onissan/digital_power/requirement.PNG

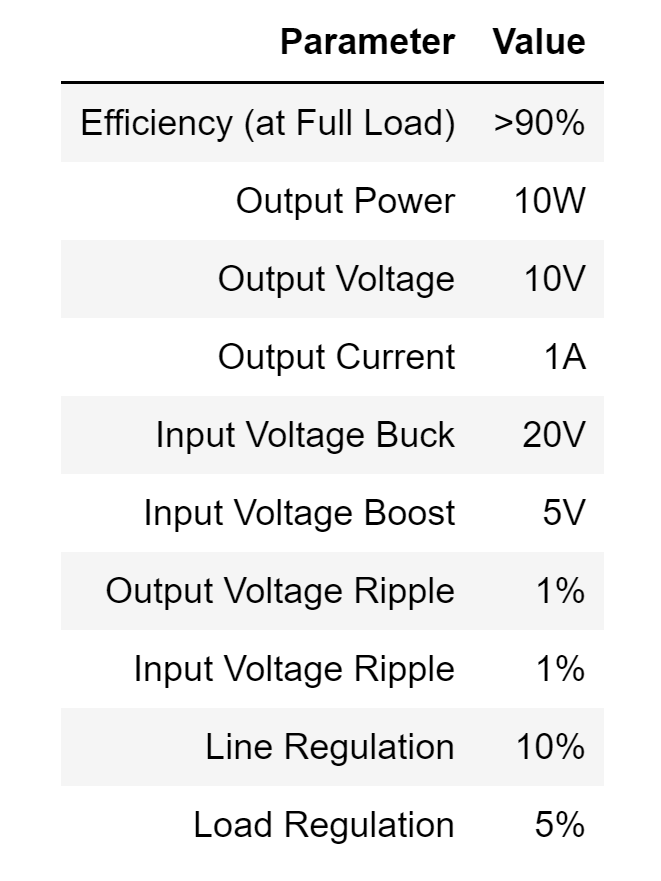
requirement.PNG
