onissan/digital_power/digital_power.pdf

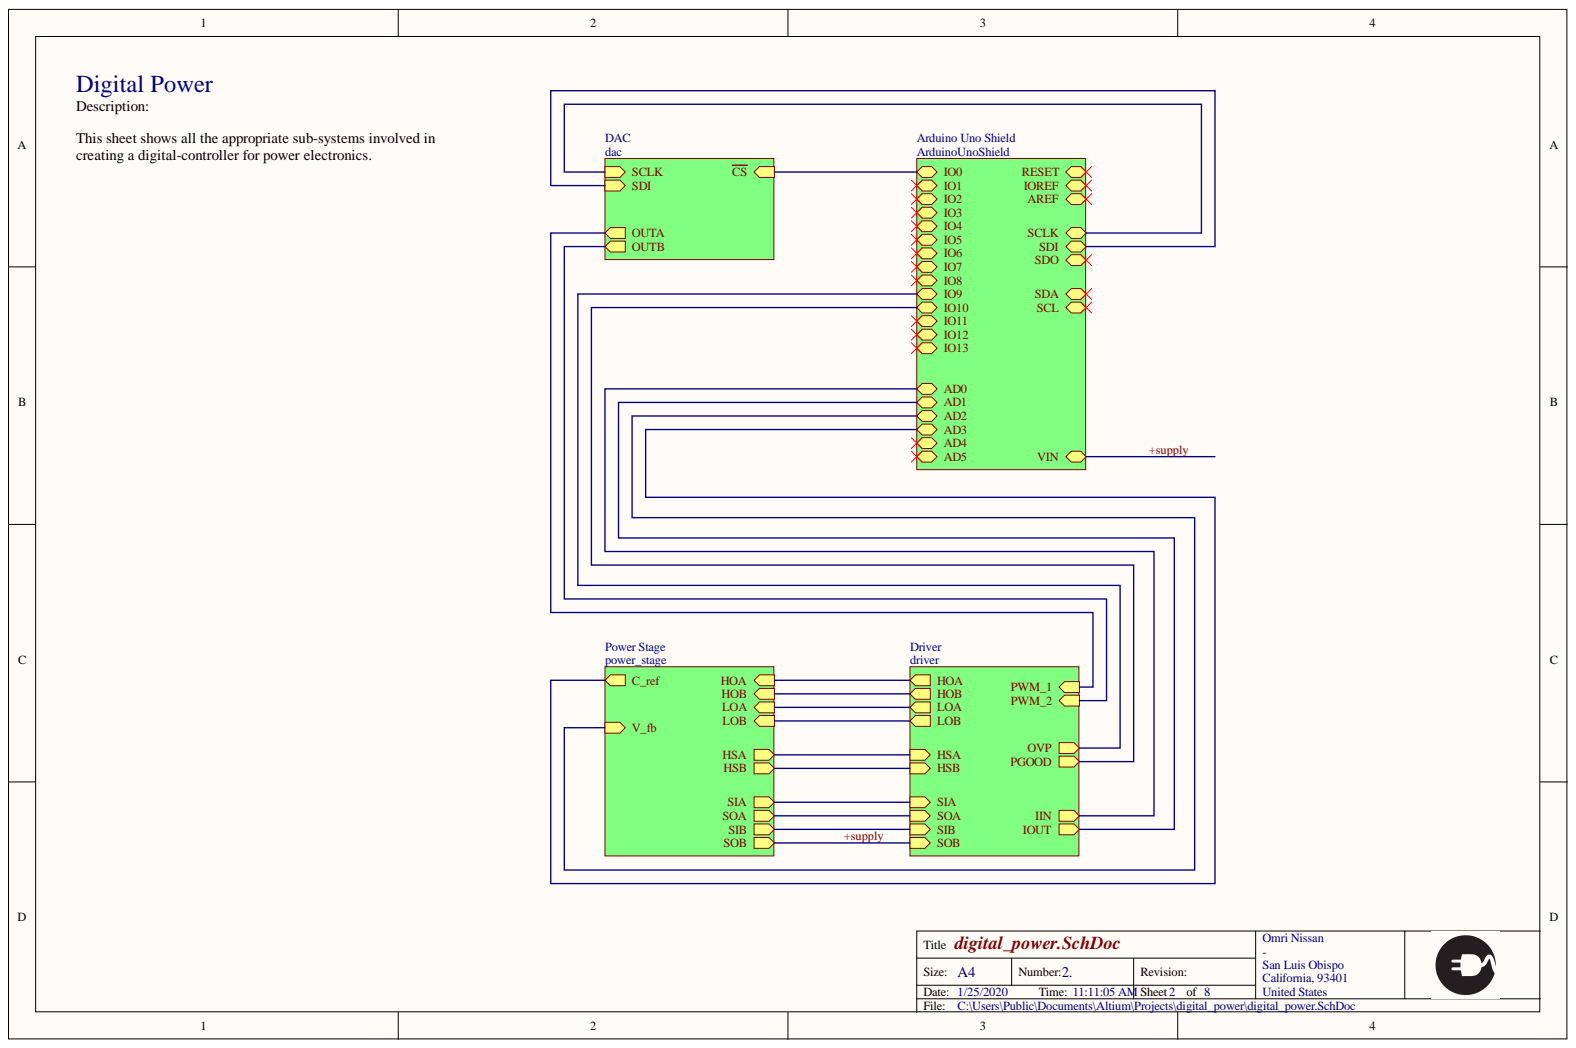
[picture p2: page 1]

This sheet shows all the appropriate sub-systems involved in
creating a digital-controller for power electronics.

Title digital_power.SchDoc | Omri Nissan -San Luis Obispo California, 93401 United States

Size: A4 | Number: 2. | Revision:

Date: 1/25/2020 Time: 11:11:05 AM | | Sheet 2 of 8
File: C:\Users\Public\Documents\Altium\Projects\digital_power\digital_power.SchDoc

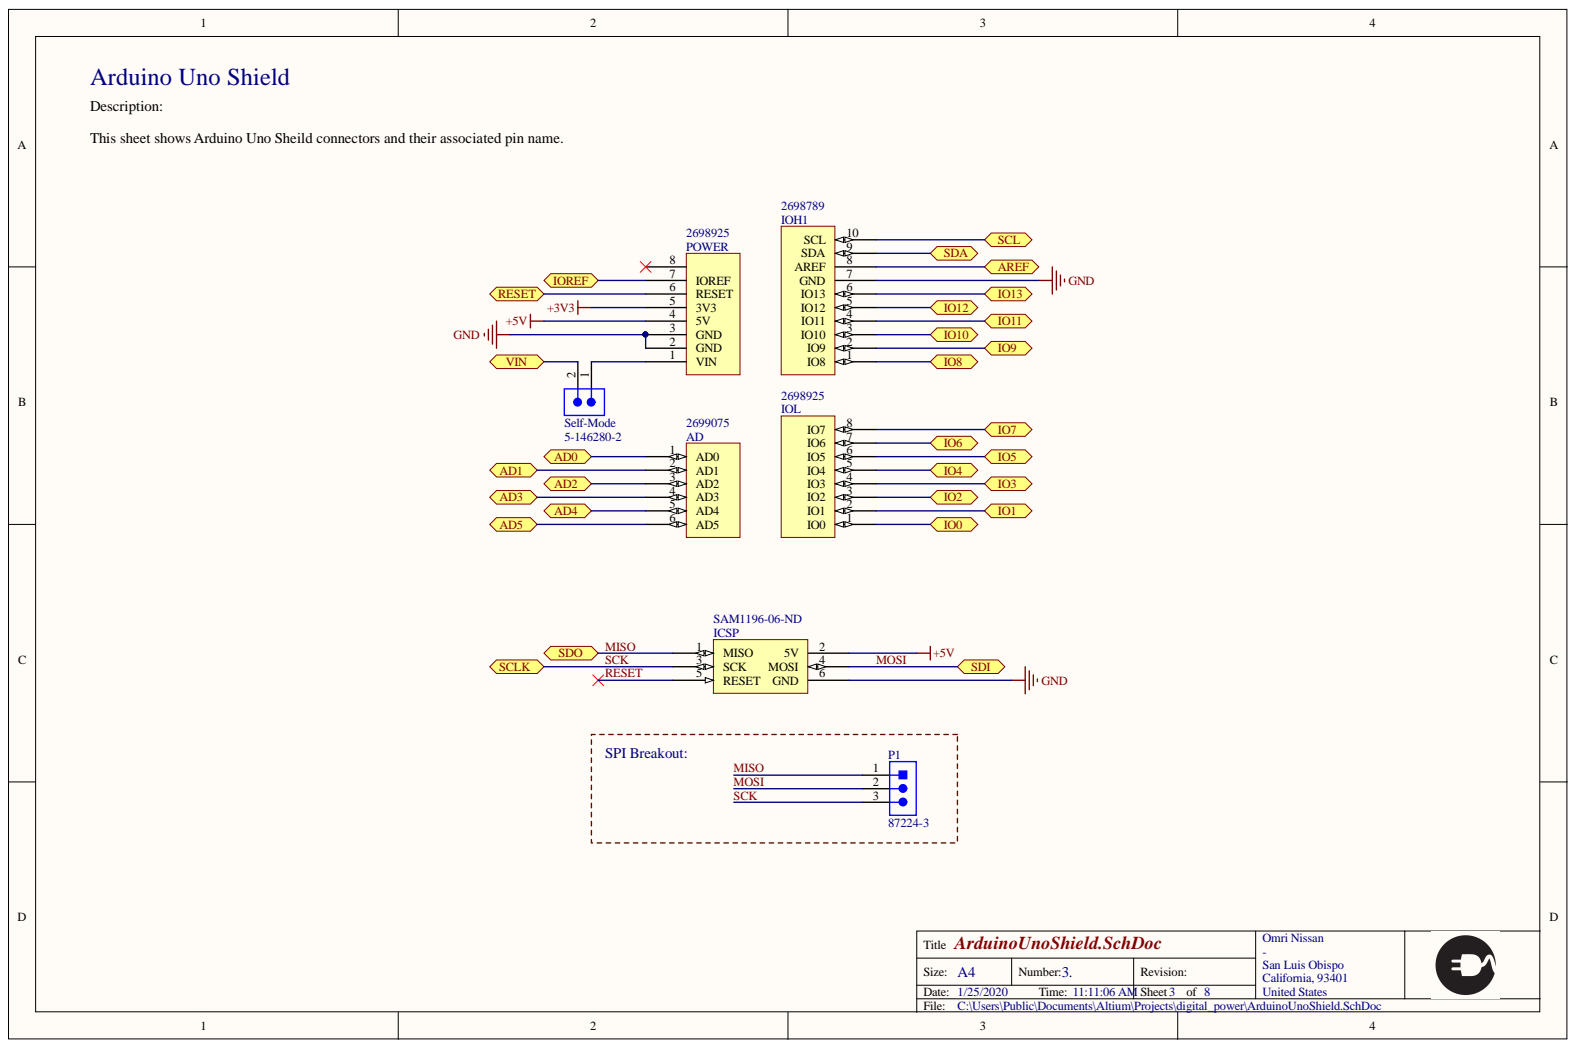
[picture p3: page 2]

This sheet shows Arduino Uno Sheild connectors and their associated pin name.

Title ArduinoUnoShield.SchDoc | Omri Nissan -San Luis Obispo California, 93401 United States

Size: A4 | Number: 3. | Revision:

Date: 1/25/2020 Time: 11:11:06 AM | | Sheet 3 of 8
File: C:\Users\Public\Documents\Altium\Projects\digital_power\ArduinoUnoShield.SchDoc

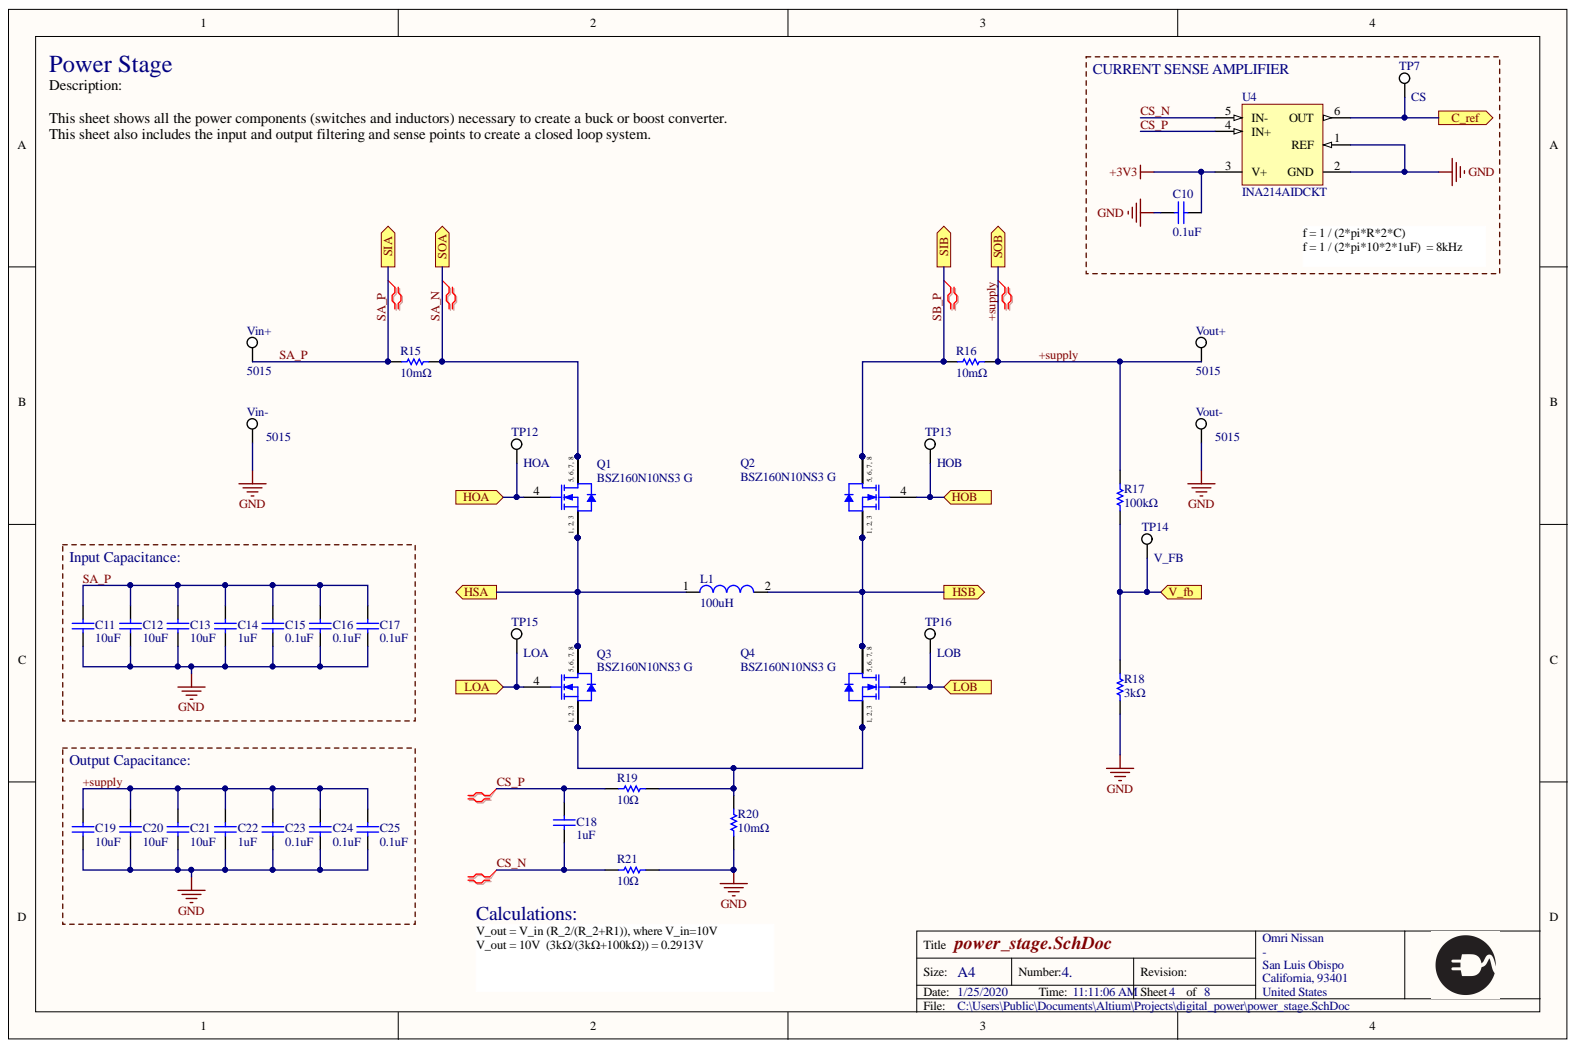
[picture p4: page 3]

This sheet shows all the power components (switches and inductors) necessary to create a buck or boost converter.
This sheet also includes the input and output filtering and sense points to create a closed loop system.

Title power_stage.SchDoc | Omri Nissan -San Luis Obispo California, 93401 United States

Size: A4 | Number: 4. | Revision:

Date: 1/25/2020 Time: 11:11:06 AM | | Sheet 4 of 8
File: C:\Users\Public\Documents\Altium\Projects\digital_power\power_stage.SchDoc

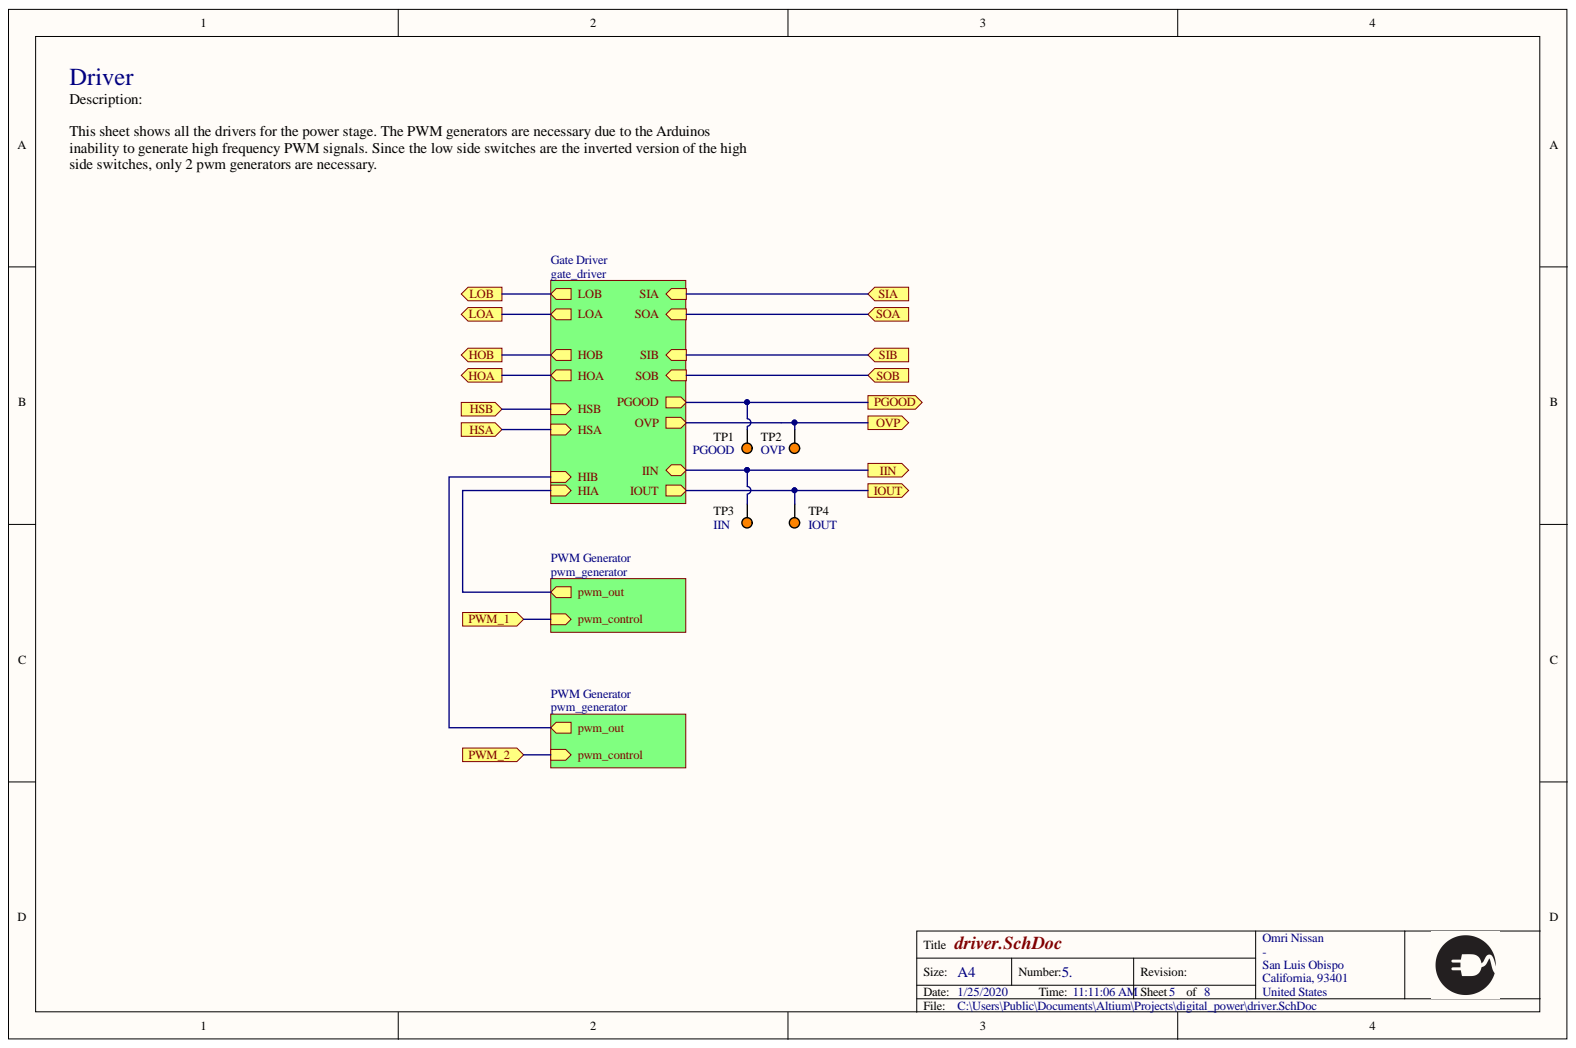
[picture p5: page 4]

This sheet shows all the drivers for the power stage. The PWM generators are necessary due to the Arduinos
inability to generate high frequency PWM signals. Since the low side switches are the inverted version of the high
side switches, only 2 pwm generators are necessary.

Title driver.SchDoc | Omri Nissan -San Luis Obispo California, 93401 United States

Size: A4 | Number: 5. | Revision:

Date: 1/25/2020 Time: 11:11:06 AM | | Sheet 5 of 8
File: C:\Users\Public\Documents\Altium\Projects\digital_power\driver.SchDoc

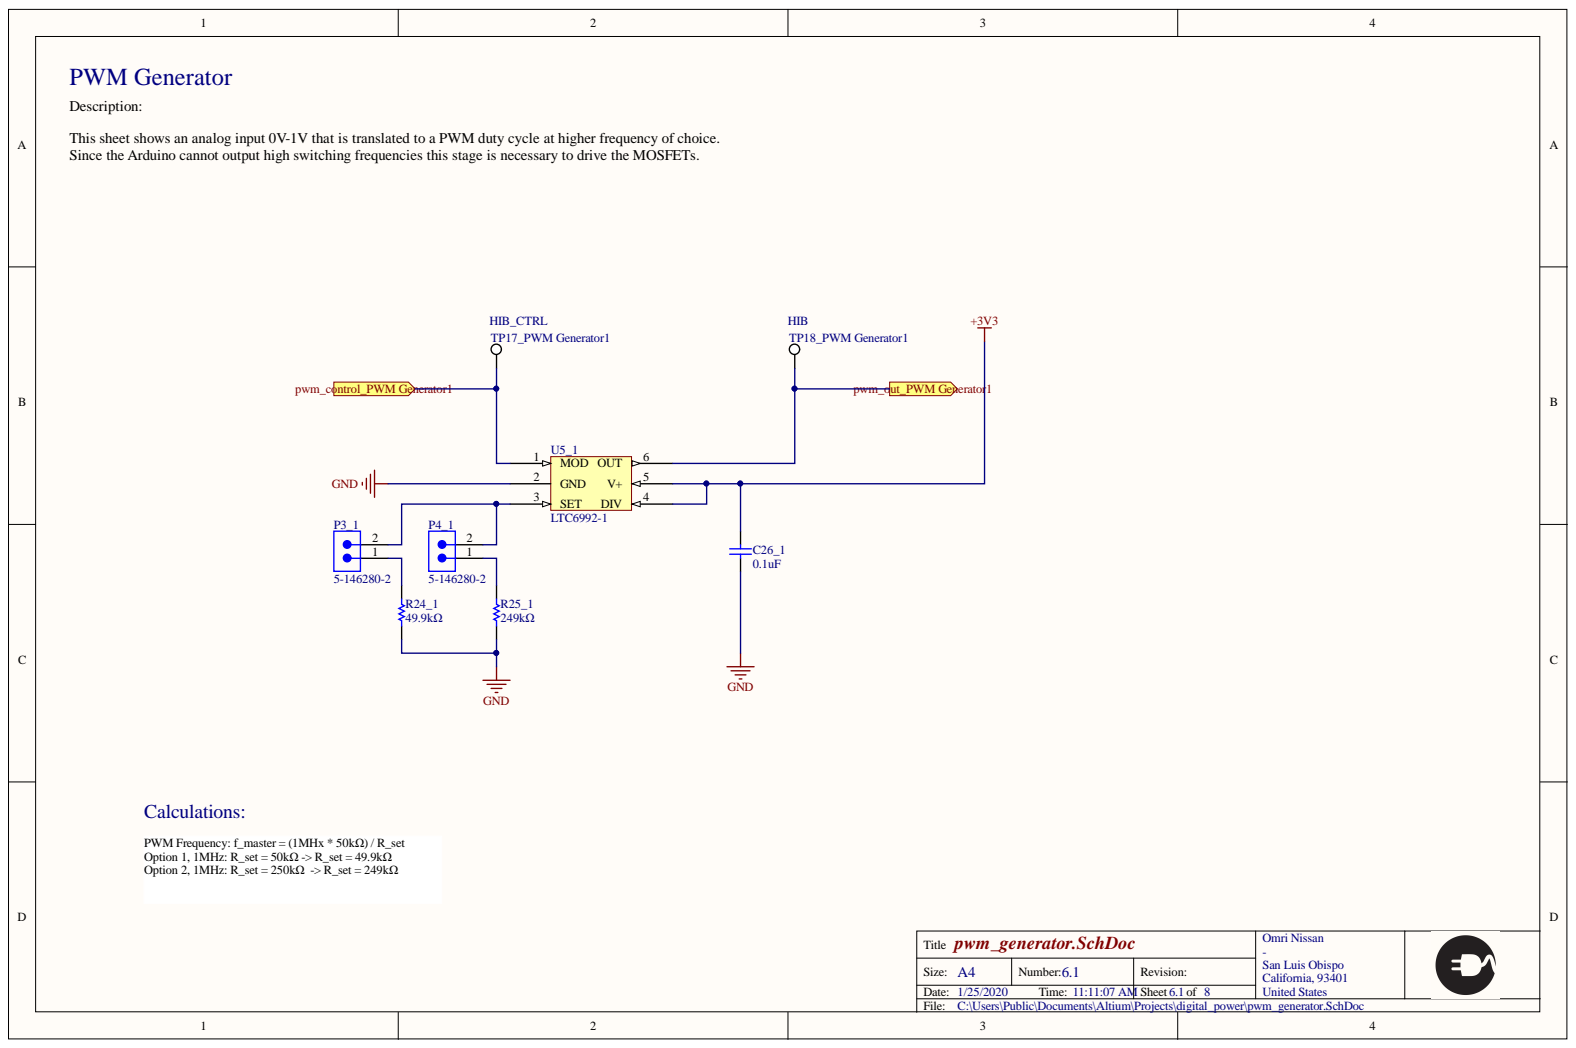
[picture p6: page 5]

This sheet shows an analog input 0V-1V that is translated to a PWM duty cycle at higher frequency of choice.
Since the Arduino cannot output high switching frequencies this stage is necessary to drive the MOSFETs.

Title pwm_generator.SchDoc | Omri Nissan -San Luis Obispo California, 93401 United States

Size: A4 | Number: 6.1 | Revision:

Date: 1/25/2020 Time: 11:11:07 AM | | Sheet 6.1 of 8
File: C:\Users\Public\Documents\Altium\Projects\digital_power\pwm_generator.SchDoc

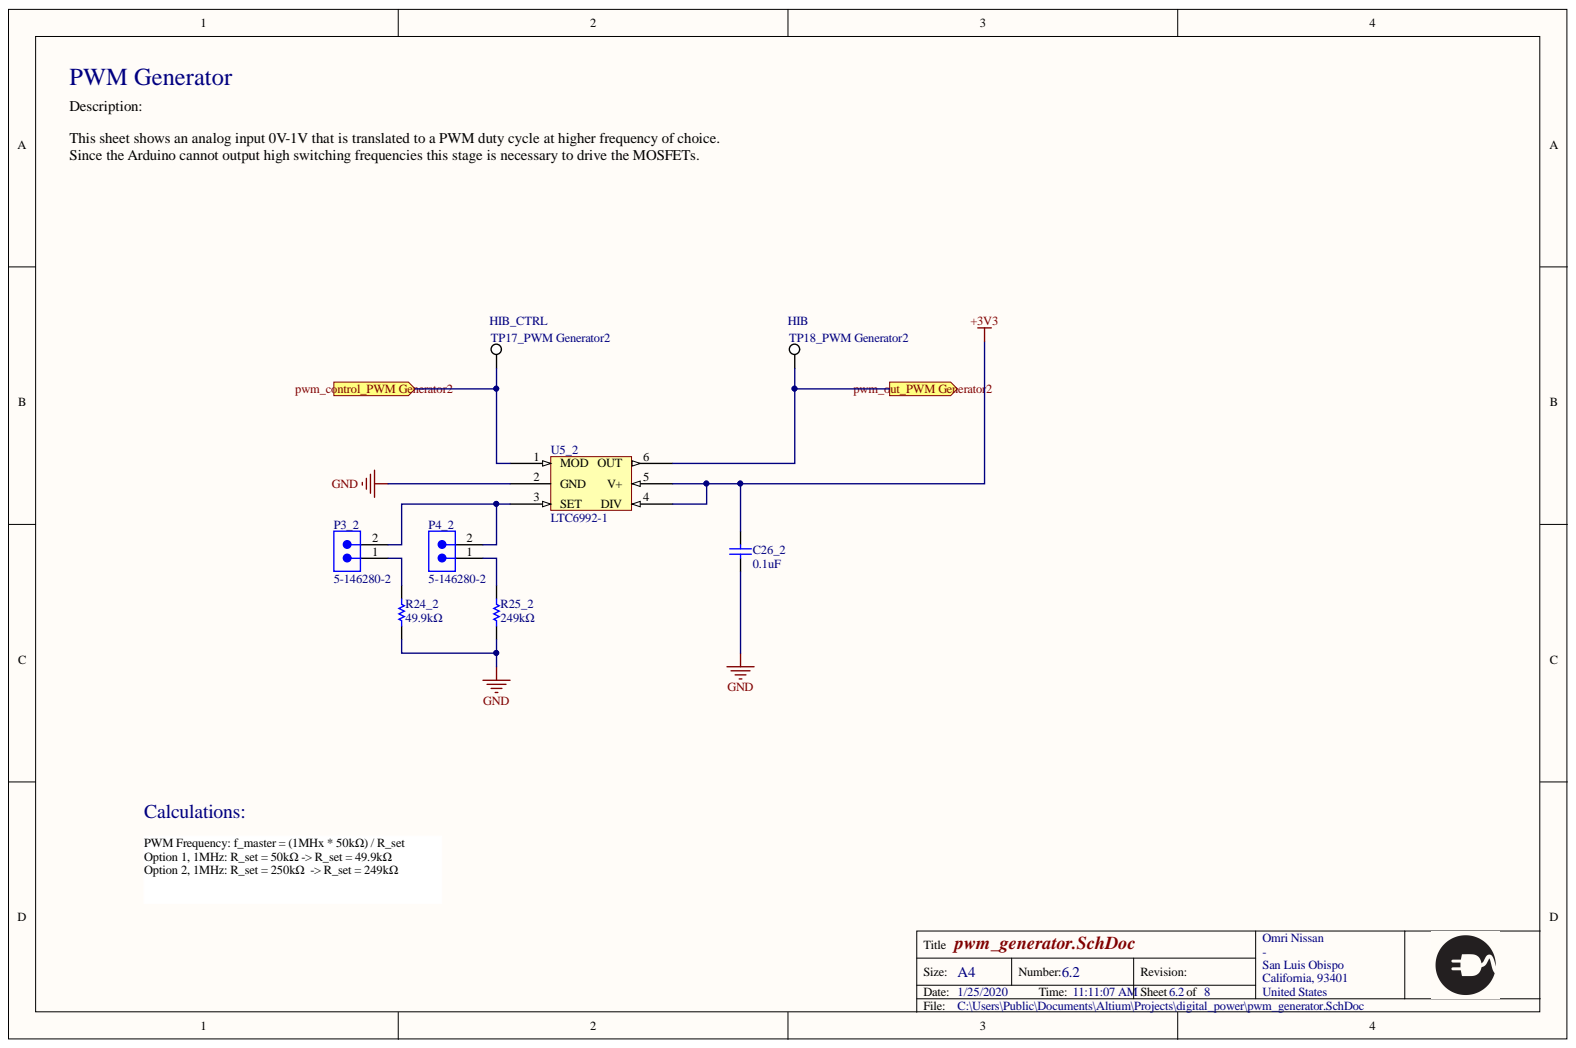
[picture p7: page 6]
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

Title pwm_generator.SchDoc | Omri Nissan -San Luis Obispo California, 93401 United States

Size: A4 | Number: 6.2 | Revision:

Date: 1/25/2020 Time: 11:11:07 AM | | Sheet 6.2 of 8
File: C:\Users\Public\Documents\Altium\Projects\digital_power\pwm_generator.SchDoc

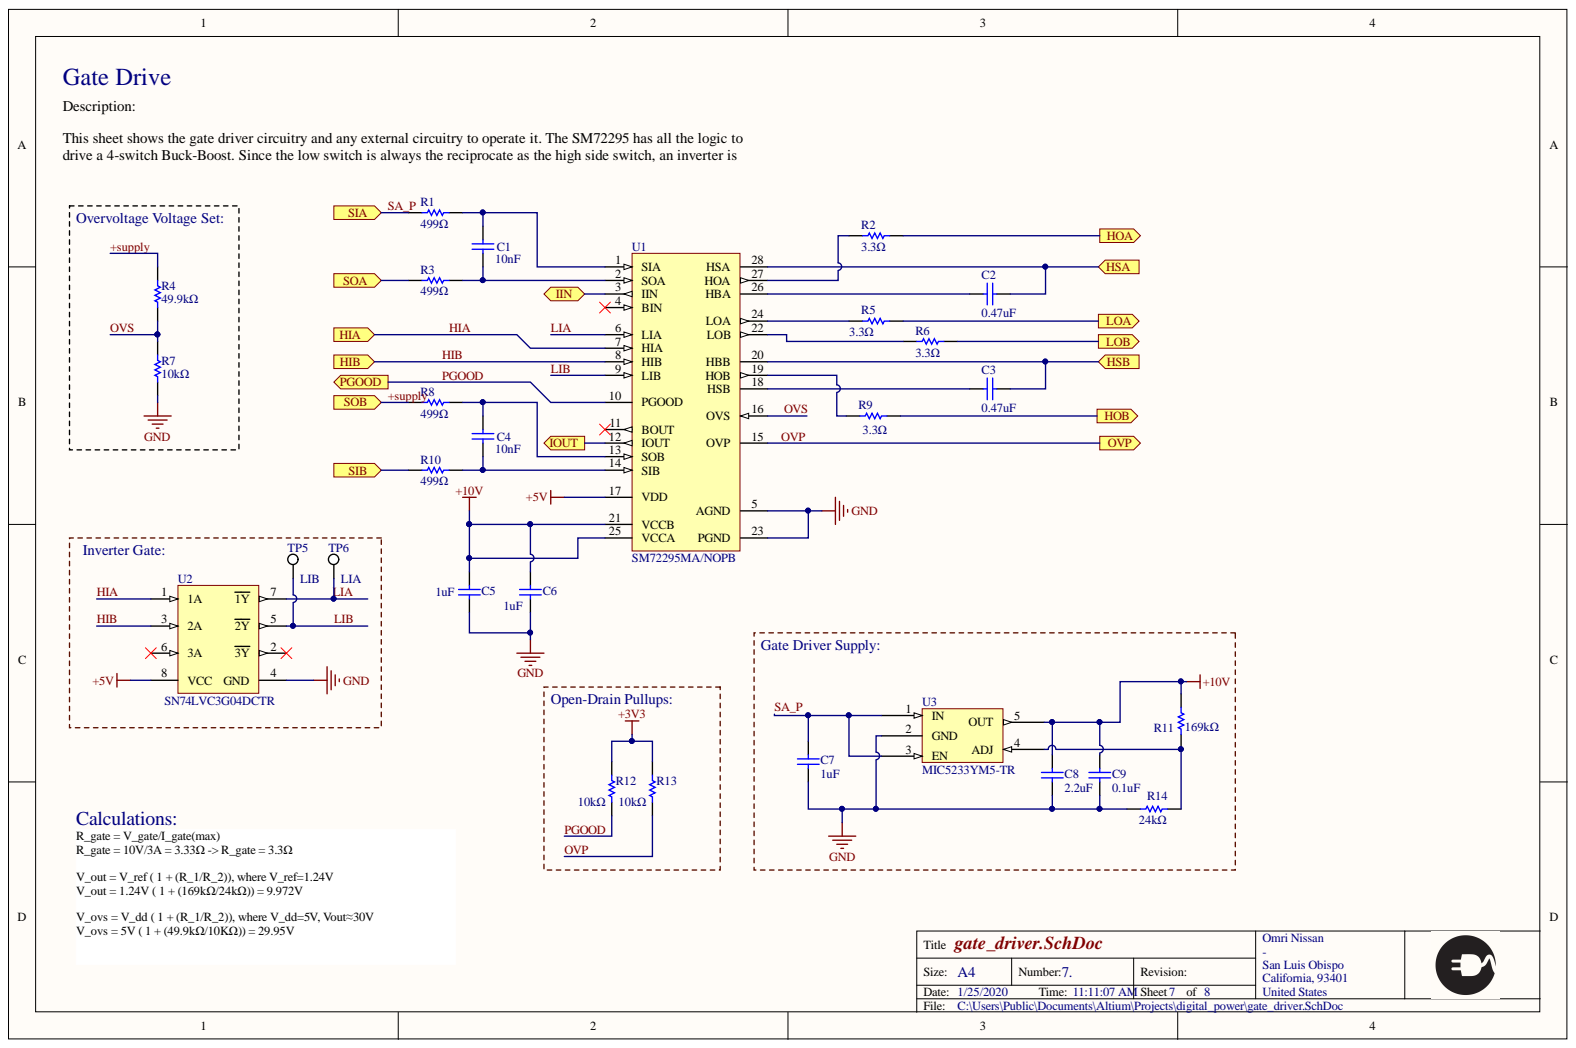
[picture p8: page 7]

This sheet shows the gate driver circuitry and any external circuitry to operate it. The SM72295 has all the logic to
drive a 4-switch Buck-Boost. Since the low switch is always the reciprocate as the high side switch, an inverter is

VDD 17

VCCA 25

Title gate_driver.SchDoc | Omri Nissan -San Luis Obispo California, 93401 United States

Size: A4 | Number: 7. | Revision:

Date: 1/25/2020 Time: 11:11:07 AM | | Sheet 7 of 8
File: C:\Users\Public\Documents\Altium\Projects\digital_power\gate_driver.SchDoc

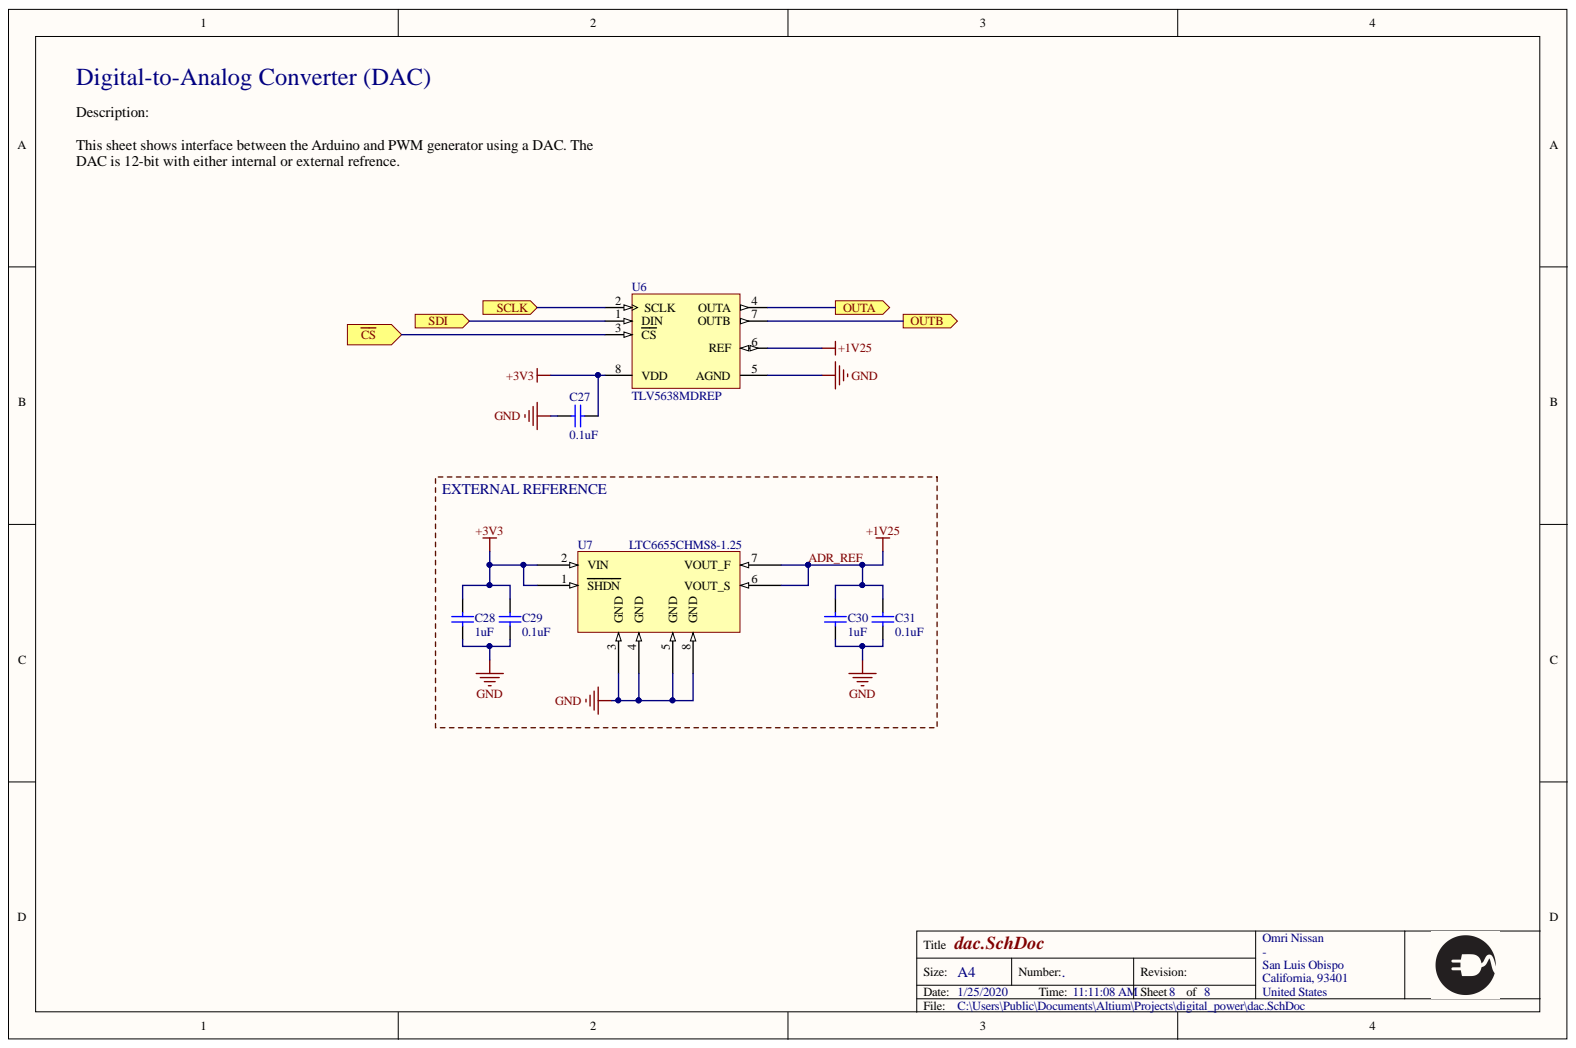
[picture p9: page 8]

Digital-to-Analog Converter (DAC)

This sheet shows interface between the Arduino and PWM generator using a DAC. The
DAC is 12-bit with either internal or external refrence.

Title dac.SchDoc | Omri Nissan -San Luis Obispo California, 93401 United States

Size: A4 | Number: . | Revision:

Date: 1/25/2020 Time: 11:11:08 AM | | Sheet 8 of 8
File: C:\Users\Public\Documents\Altium\Projects\digital_power\dac.SchDoc

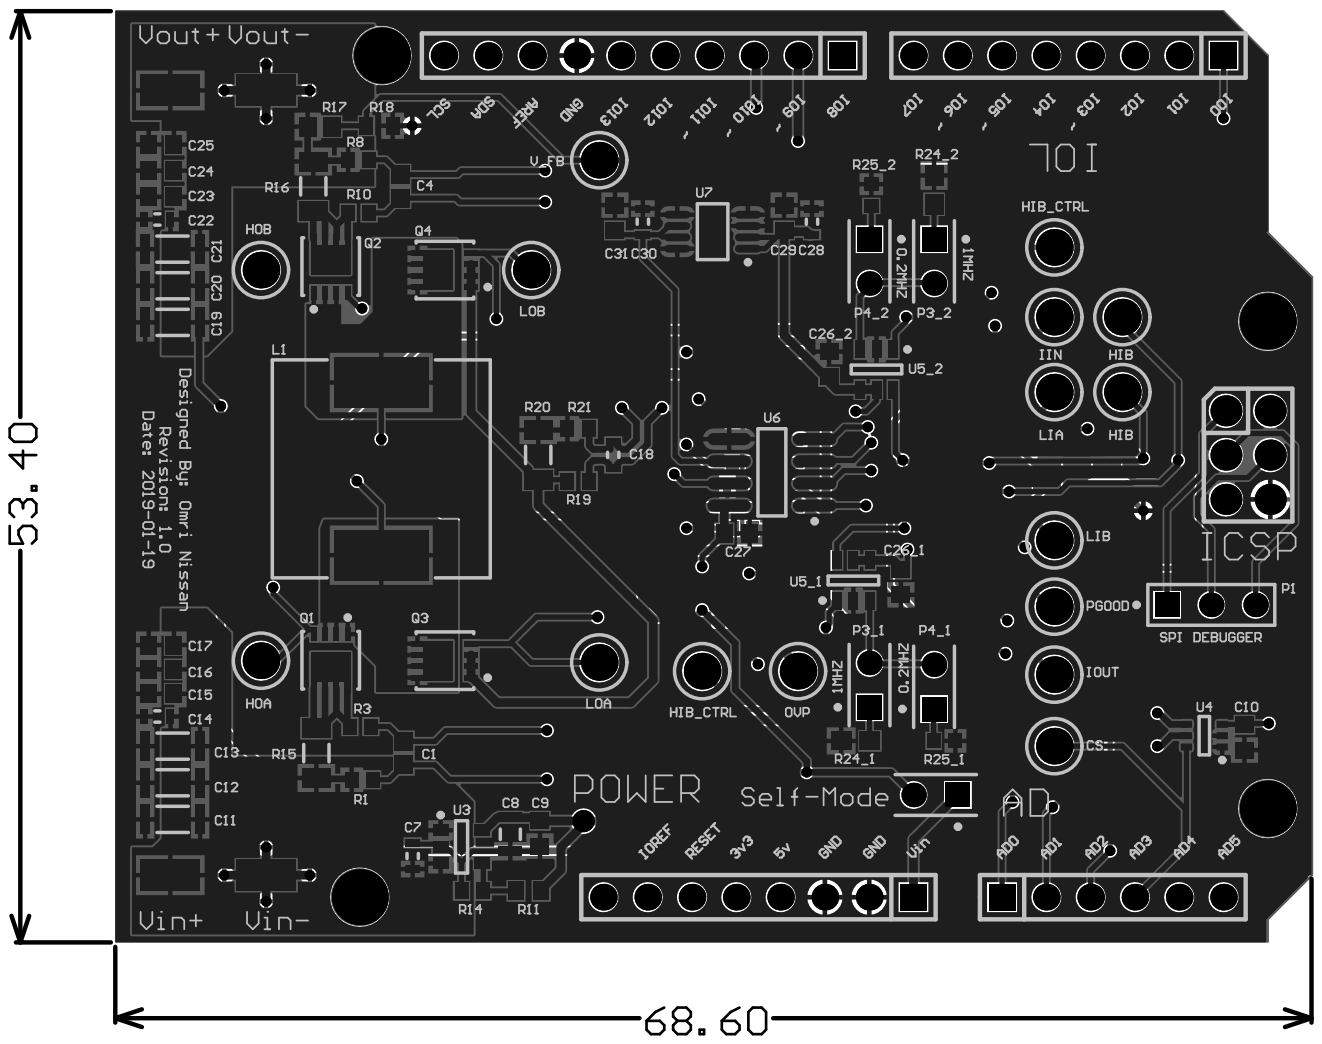
[picture p10: page 9]
