onissan/digital_power/Simulation/LT6992-1.asc

R1: res; 200k
R4: res; 10k
U1: LTC6992-1
V1: voltage; 3.3
V2: voltage; PULSE(0 1 5m 1m 1m 1m)
Named nets: 0, PWMout
.tran 10m startup
1MHz, 100% to 0% Duty Cycle
Swept Pulse Width Modulated Output
Startup Modeled
