onissan/digital_power/Simulation/4_sw_converter_boost.asc

C1: cap; 50µ
C2: cap; 50µ
L1: ind; 100µ
R1: res; 10
R2: res; 10m
S1: sw
S2: sw
S4: sw
S5: sw
V1: voltage; 5
V2: voltage; 5
V3: voltage; 0
V4: voltage; PULSE(0 5 {D/f} 1n 1n {D/f} {1/f})
V5: voltage; PULSE(0 5 0 1n 1n {D/f} {1/f})
Named nets: 0, Vout, Vin, INA_L_BUCK, INB_H_BUCK, INB_L_BUCK, INA_H_BUCK
BOOST CONVERTER GATE DRIVE
.tran 0 100m 0
.model SW SW (Ron=1n Roff=1E9 Vt=1 Vh=-0.5)
.param D=0.5
.param f=200E3
