onissan/digital_power/(list of files, drawings)

Other design files:
adc.SchDoc
adc_power.SchDoc
adc_signal.SchDoc
ArduinoUnoShield.SchDoc
cover_page.SchDoc
dac.SchDoc
digital_power.PcbDoc
digital_power.PrjPcb
digital_power.SchDoc
digital_power.SCHLIB
driver.SchDoc
gate_driver.SchDoc
power_stage.SchDoc
pwm_generator.SchDoc
