onissan/digital_power/(commit log)

2020-01-27 Revision 1 - Digital PCB. Also includes design jupyter notebook.
    [ArduinoUnoShield.SchDoc, adc.SchDoc, adc_power.SchDoc, adc_signal.SchDoc, cover_page.SchDoc, dac.SchDoc, digital_power.PcbDoc, digital_power.PrjPcb]
2020-08-09 Rev 2.0 fixed shorting ground and other layers/signals. Highligh new fixes for Rev3.0.
    [ArduinoUnoShield.SchDoc, dac.SchDoc, digital_power.PcbDoc, digital_power.PrjPcb, digital_power.SchDoc, driver.SchDoc, gate_driver.SchDoc, power_stage.SchDoc]
